danny-andersen/digi-thermostat/README.md

# digi-thermostat
Arduino project for a digital thermostat that allows remote control of a central heating boiler. Eat your heart out Nest.
