danny-andersen/digi-thermostat/Logic-Flow.pptx

Read
RTC

Read
PIR

Read
Button Inputs

Now >=
TempTime

Yes

Read
Thermometer
Set TempTime=now + temp delay

Read
Set Temp for
Time now

Tripped?

Yes

Temp+/-?

Yes

Inc/Dec
Set Temp

Override?

Yes

Set New_Boiler = on
Set BTimeOff = now + 30min

Set Temp
>
Current?

Yes

Set New_Boiler
= on

Now > LightTimer?

Set Backlight on
Set LightTimer=
now + 30s

No

Set New_Boiler
= off

Store new Set Temp
For time now

Set Backlight
off

[Turn Boiler off]
Boiler_on = 0
[Open Relay]

new_boiler == off &&
Now >= BTimeOff

True

[Turn Boiler on]
Boiler_on = 1
[Close relay]

False

Display:
Current Date + Time
Current Temp + RH
Set Temp
Boiler Status
(BTimeOff - now)

If mins != last_tx_mins
Send status
