danny-andersen/digi-thermostat/mainboard-stripboard-graphic.gif

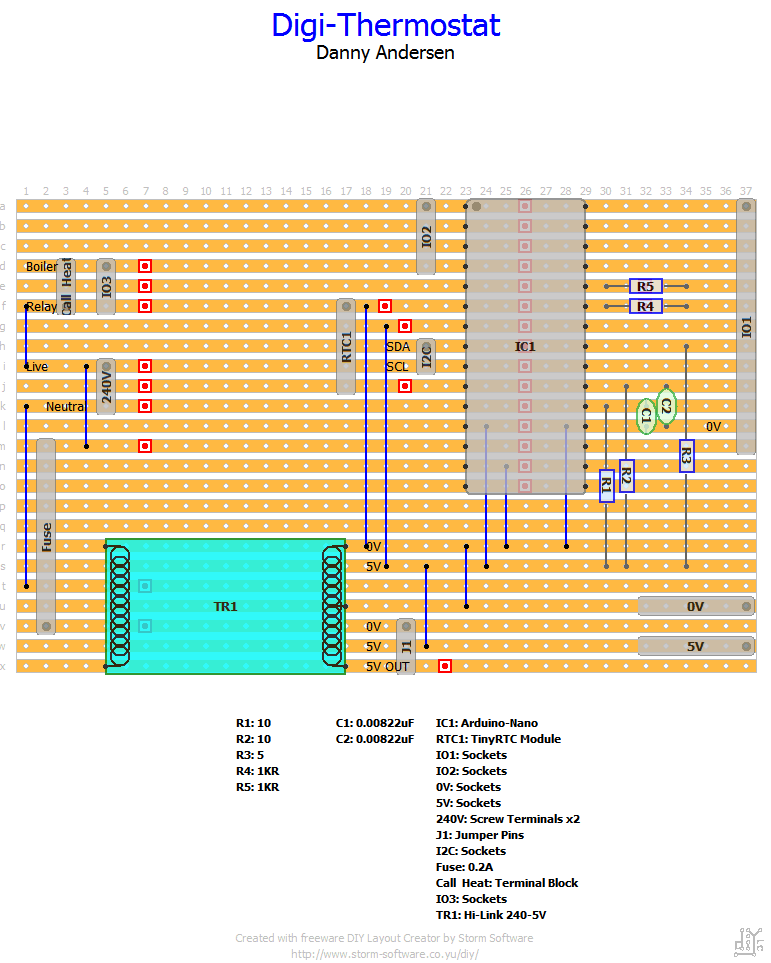
mainboard-stripboard-graphic.gif
