danny-andersen/digi-thermostat/Mainboard_schematic.pdf

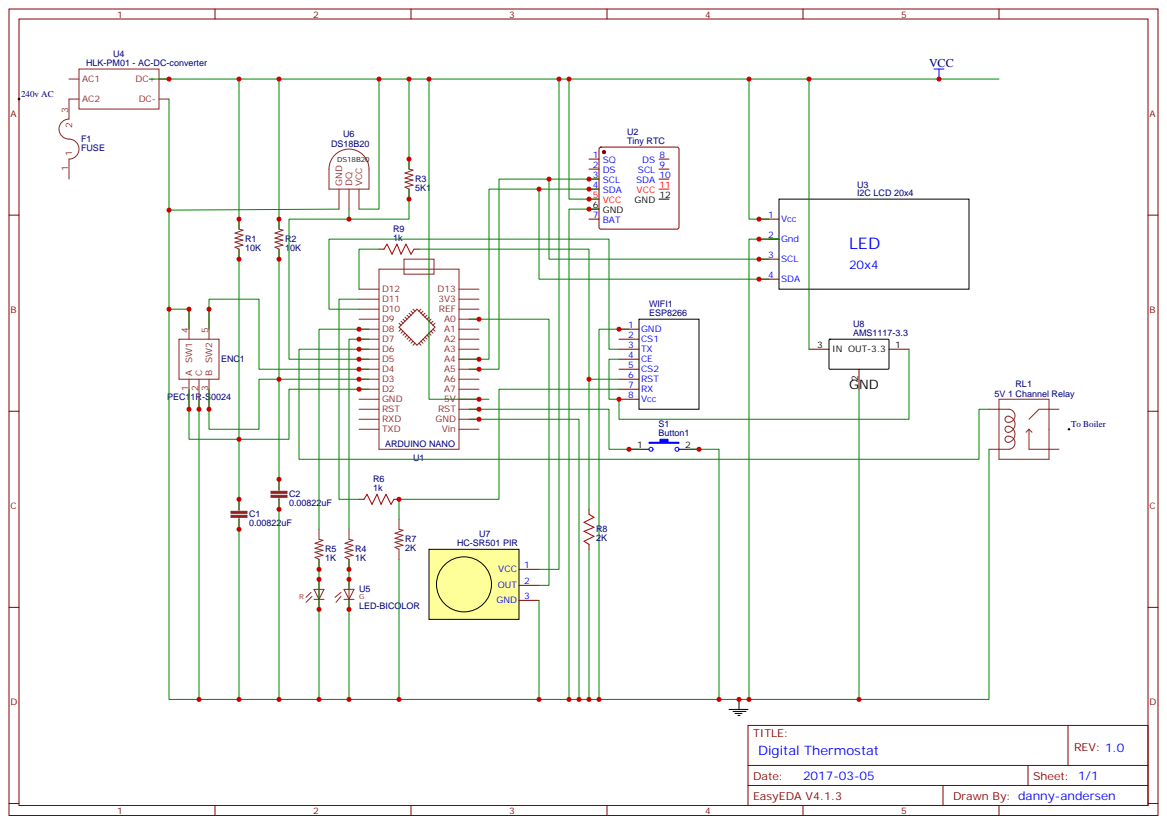
[picture p2: page 1]
