danny-andersen/digi-thermostat/mainboard_layout.pdf

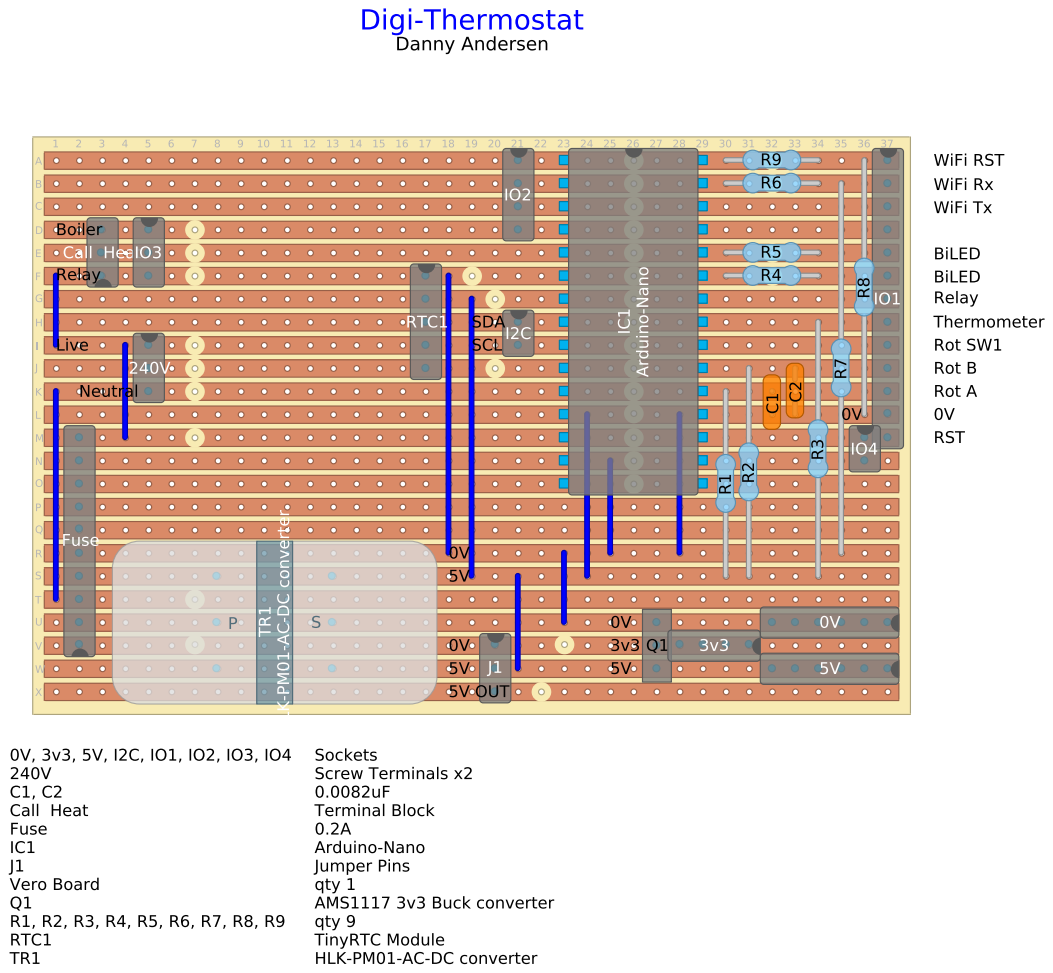
[picture p3: page 1]
