danny-andersen/digi-thermostat/(list of files, drawings)

Other design files:
Mainboard-Easyeda-source.json
