danny-andersen/digi-thermostat/monitor_home/capture-camera.py

from time import sleep
from fractions import Fraction
from picamera import PiCamera
from datetime import datetime
import subprocess
import os

WEB_CAM = False
DATE_FORMAT: str = "%Y%m%dT%H%M%S"
STATUS_FILE = "/home/danny/digi-thermostat/masterstation/status.txt"
MAX_LAST_UPDATE = 5 * 60
TAKE_PHOTO_FILE: str = "/home/danny/digi-thermostat/monitor_home/take-photo.txt"
DEVICES_FILE = "/home/danny/digi-thermostat/monitor_home/lan_devices.txt"


class Camera:
    _webcam_enabled: bool
    _camera: PiCamera
    photoFilenamePi: str = "-piphoto.jpeg"
    photoFilenameWeb: str = "-webphoto.jpeg"
    videoFilename: str = "-pioutput"

    ffmegStr = "ffmpeg -f v4l2 -video_size 1280x720 -i /dev/video1 -r 3.0 -frames 1 -y"
    mp4ConvStr = "MP4Box -add"
    devnull = " >/dev/null"

    def __init__(self, web_cam_on: bool, camera: PiCamera = None):
        self._webcam_enabled = web_cam_on
        self._camera = camera

    def _getCamera(self):
        if not self._camera:
            self._camera = PiCamera()
            self._camera.framerate = Fraction(25, 1)
            self._camera.iso = 800
        return self._camera

    def _closeCamera(self):
        if self._camera:
            self._camera.close()
            self._camera = None

    def takePhoto(self, dateStr: str):
        # Take photo with picam
        camera = self._getCamera()
        camera.resolution = (1024, 768)
        camera.capture(f"{dateStr}{self.photoFilenamePi}")
        self._closeCamera()
        if self._webcam_enabled:
            # Take webcam photo
            ffmegCmd: list = self.ffmegStr.split()
            ffmegCmd.append(f"{dateStr}{self.photoFilenameWeb}")
            ffmegCmd.append(self.devnull)
            subprocess.run(args=ffmegCmd)

    def takeVideo(self, dateStr: str):
        outfile: str = f"{dateStr}{self.videoFilename}"
        camera = self._getCamera()
        camera.start_recording(
            output=f"{outfile}.h264", format="h264", resize=(640, 480)
        )
        camera.wait_recording(30)
        camera.stop_recording()
        self.wrapH264(outfile)

    def wrapH264(self, videoName: str):
        mp4cmd: list = self.mp4ConvStr.split()
        mp4cmd.append(f"{videoName}.h264")
        mp4cmd.append(f"{videoName}.mp4")
        #    mp4cmd.append(devnull)
        # TODO run the conversion command in the background and delete following conversion
        subprocess.run(args=mp4cmd)
        os.remove(f"{videoName}.h264")


def readPirStatus():
    pir = False
    # First check that status file is recent - only read it if in past x mins
    statfile: os.stat_result = None
    try:
        statfile = os.stat(STATUS_FILE)
    except:
        statfile = None
    nowTime = datetime.now().timestamp()
    if statfile and (nowTime - statfile.st_mtime < MAX_LAST_UPDATE):
        with open(STATUS_FILE, "r", encoding="utf-8") as statusf:
            line: str = " "
            while line != "":
                line: str = statusf.readline()
                if line.startswith("PIR:"):
                    val = int(line[line.index(":") + 1])
                    if val:
                        pir = True
    return pir


def checkForPhotoCmd():
    # Check for photo command
    takePhoto: bool = False
    try:
        statfile = os.stat(TAKE_PHOTO_FILE)
        takePhoto = True
        os.remove(TAKE_PHOTO_FILE)
    except:
        takePhoto = False
    return takePhoto


# Check if any recognised mobile devices are on the network
def noOneHome():
    noOneHome = True
    try:
        statfile: os.stat_result = os.stat(DEVICES_FILE)
        # print(f"device file size: {statfile.st_size}")
        if statfile.st_size > 0:
            noOneHome = False
    except:
        noOneHome = True

    return noOneHome


# Start

camera: Camera = Camera(WEB_CAM)
while True:
    # if no one home - start monitoring
    if noOneHome():
        # Check pir is on
        while readPirStatus():
            # record in 30 second segments whilst pir status is on
            # and no one is home
            dateStr: str = datetime.now().strftime(DATE_FORMAT)
            camera.takePhoto(dateStr)
            camera.takeVideo(dateStr)
    if checkForPhotoCmd():
        dateStr: str = datetime.now().strftime(DATE_FORMAT)
        camera.takePhoto(dateStr)
    sleep(0.5)
