danny-andersen/digi-thermostat/masterstation/parse_bbc.py

if __name__ == "__main__":
    from bs4 import BeautifulSoup
    from datetime import datetime,time
    import sys

    if len(sys.argv) != 2:
	 sys.stderr.write("Please provide a file to parse\n")
	 sys.exit(1)
    html = BeautifulSoup(open(sys.argv[1]).read(), "lxml")
    #Find start of hourly forecast
    hourly = html.find("table", class_="moving-window");
    hours = []
    for tr in hourly.find_all(class_="time"):
        for th in tr.find_all("th"):
	    for hr in th.find_all("span",class_="hour"):
		hours.append(hr.string)
    print hours
    weather = []
    for tr in hourly.find_all(class_="weather-type"):
        for td in tr.find_all("td"):
	    for hr in td.find_all("img"):
	    	weather.append(hr["title"])
    print weather
    temp = []
    for tr in hourly.find_all(class_="temperature"):
	i = 0
        for td in tr.find_all("td"):
	    for hr in td.find_all("span",attrs={"data-unit": "c"}):
		i = True
	    	for st in hr.strings:
		    if (i):
		    	temp.append(st);
		    i = not i
    #Use observation module
    #tempTag = html.find("p", class_="temperature");
    #if (tempTag != None):
    #    for hr in tempTag.find_all("span",attrs={"data-unit": "c"}):
    #	   for st in hr.strings:
    #	       temp.append(st);
    print temp
    windSpeed = []
    windDirection = []
    for tr in hourly.find_all(class_="windspeed"):
        for td in tr.find_all("td"):
	   for hr in td.find_all("span",class_="windspeed-value-unit-mph"):
	    	for st in hr.stripped_strings:
    	   	    windSpeed.append(st);
	   for hr in td.find_all("span",class_="description"):
	    	for st in hr.stripped_strings:
    	   	    windDirection.append(st);
    windDir = windDirection[0].split()
    windDirAbbr = ""
    for wdw in windDir:
	windDirAbbr += wdw[0];
    wind = windSpeed[0]+windSpeed[1]+" " + windDirAbbr

    sunrise = html.find(class_="sunrise")
    sunriseStr = sunrise.string;
    sunriseHr = int(sunriseStr.split()[1].split(':')[0])
    sunset = html.find(class_="sunset")
    sunsetStr = sunset.string;
    sunsetHr = int(sunsetStr.split()[1].split(':')[0])

    #Find when the weather changes and say when
    startWeather = weather[0]
    end = 0
    endWeather = ""
    for s in weather:
	if s != startWeather:
	   endWeather = s
	   break
	end += 1
    if end >= len(hours): 
	end -= 1 
    #Look for rain
    rainTime = 0
    rain = ""
    for s in weather:
	if s == "Thunderstorm" or s.lower().find("rain") != -1:
	    rain = s
	    break
        rainTime += 1
    if rainTime >= len(hours): 
	rainTime = -1 

    #Put it all together
    forecast = startWeather + " until " + hours[end] + "00"
    if rainTime != -1 and rainTime != end and rain != startWeather:
	forecast += ". " + rain + " at " + hours[rainTime] + "00"
    elif endWeather != "":
	forecast += " and then " + endWeather
    now = datetime.now().time() 
    if now.hour <= sunriseHr + 1:
	forecast = sunriseStr + ", " + forecast
    elif now.hour > 14 and now.hour <= sunsetHr + 1:
	forecast = sunsetStr + ", " + forecast
    #print forecast
    expiry = abs(now.hour - int(hours[end])) * 3600 * 1000;

    #Save output into files for sending to thermostat
    #Save first hour temp as ext temp
    with open("setExtTemp.txt", "w") as f:
	f.truncate()
	f.write(temp[0] + "\n")
    	f.write(wind + "\n")
    #Add expiry to motd
    with open("motd.txt", 'w') as f:
	f.truncate()
	f.write(forecast + "\n")
	f.write("%d" % expiry + "\n")
    
