danny-andersen/digi-thermostat/(commit log)

2017-01-22 Corrected rtc date conversion
    [digi-thermostat.ino, read_thermometer_display_oled.ino, thermometer_and_RTC.ino]
2017-01-23 Changed display to LCD as OLED unreliable I2C interface
2017-01-25 Added switches and schedule processing
2017-01-27 Debounced buttons
2017-01-29 Changed to a 20x4 LCD display. Added run timers
2017-02-03 Configured radio and changed to use rotary encoder to set temp
2017-02-04 Better debounce of ALPS rotary encoder to set temp
2017-02-20 Change rotary encoder for PEC11R unit which has proper phase shifted A and B signals
2017-02-26 Fixed set of clock
    [digi-thermostat.ino]
2017-03-01 Corrected LCD backlight and added processing of BBC weather site data
    [parse_bbc.py]
2017-03-03 Fixed sending and saving schedules
    [masterstation.cpp]
2017-03-03 Fixed saving of schedules by adding delay after write
    [digi-thermostat.ino]
2017-03-03 Fixed runtime calc and display of temp <10
    [digi-thermostat.ino]
2017-03-04 Bit of rewiring and added relay
2017-03-05 Fixed wind speed display
    [digi-thermostat.h, digi-thermostat.ino]
2017-03-06 Added first drafft of schematic
2017-03-06 Added final version of schematic
2017-03-13 Committed correct version of masterstation
    [digi-thermostat.h, masterstation.cpp]
2017-03-17 Updated schematic
2017-03-19 Added veroboard layout
    [Mainboard-Easyeda-source.json]
2017-03-25 Set power to the max
2017-04-09 Reset radio if msg not received for a while as radio appears to hang periodically and needs to be reset
    [digi-thermostat.h, digi-thermostat.ino]
2017-05-12 Fixed sendTemp bug when temp not read correctly
    [masterstation.cpp]
2018-08-27 Added safe devices
2019-04-22 Changed Temp in devices file to show tenths of degree and added boiler status change
2021-05-23 Fixed re-installation errors and changes
    [masterstation.cpp]
2021-05-24 Fixed null temperature reading and added missing files required on first run
2022-09-27 Major changes to use wifi module rather than RF24 radio for more reliable comms
    [Mainboard-Easyeda-source.json]
2022-09-30 Fixed sending boiler runtime and pir status
    [digi-thermostat.h, digi-thermostat.ino]
2022-10-10 Various display fixes and RTC fixes
    [digi-thermostat.h, digi-thermostat.ino, masterstation.py]
2022-10-11 Fixed display errors and calc of manual holiday time
    [digi-thermostat.h, digi-thermostat.ino]
2022-10-11 Fixed holiday sending and boiler off status
    [masterstation.py]
2022-10-12 Changed holiday adj to 15mins. Attempt fix at local therm reading
    [digi-thermostat.h, digi-thermostat.ino]
2022-10-16 Fixed Run time being too long
    [digi-thermostat.ino]
2022-10-17 Corrected schedule day due to RTC day change
    [digi-thermostat.ino, masterstation.py]
2022-11-08 Reset if wifi down for more than 15mins and dont allow manual override of holiday temp
    [digi-thermostat.h, digi-thermostat.ino, wifi.h]
2022-11-30 Fixed motdexpiry being less than zero
    [masterstation.py]
2022-12-11 Added remote reset functionality
    [digi-thermostat.h, digi-thermostat.ino, masterstation.py]
2022-12-13 Adjust local temp read, corrected temp display Fixed sending reset command
    [digi-thermostat.h, digi-thermostat.ino, masterstation.py]
2022-12-14 Fixed overriding temp during man holiday. Also rounded holiday time to nearest 15 mins Also fixed boiler run time - send mins not tms
    [digi-thermostat.ino]
2022-12-16 Fixed backlight not switching off by changing LCD library
    [digi-thermostat.ino]
2023-01-02 First commit of new camera capture based on PIR status
2023-01-02 Added constructor to Camera class
2023-01-02 Added arduino vscode config
2023-01-02 Run camera capture and monitor script on threads off masterstation.service
2023-01-03 Release file lock once threads created
2023-01-03 Run uwsgi web server with uid and gid set Allows threads to work correctly
2023-01-04 Changed tp multiprocess rather than threads
2023-01-07 Stop taking pictures every hour Only do if no devices in camera capture
2023-01-07 Changed network failure handling. Fixed next schedule at weekend
    [digi-thermostat.h, digi-thermostat.ino]
2023-01-08 Corrected updated status file on change
    [masterstation.py]
2023-01-15 Do a full reset if not heard from masterstation for 3x wifi timeout And set temp to invalid if local therm is broken and no remote temp
    [digi-thermostat.h, digi-thermostat.ino]
2023-01-18 Replaced PIR sensor and so re-enabled out of hours video taking
2023-01-18 Added humidity sensor Moved reading sensor to monitor thread to speed up response times
2023-01-18 Moved reading sensor to monitor thread
2023-01-18 Ignore sensor failure value
    [masterstation.py]
2023-01-22 Reset device after x3 wifi reboots every 5mins Send wifi reset in reset flag
    [digi-thermostat.h, digi-thermostat.ino, masterstation.py]
2023-01-22 Added libraries local to sketch as per Arduino ide change
2023-01-27 Calculate average temp + humidty for history Edit lan devices rather than creating from new
2023-02-03 Fixed truncation of device change file
2023-03-04 Added timeout on waiting for camera completing
2023-03-04 Added missing date to device file
2023-09-13 Added missing files from backup post recovery
    [thermometer_and_RTC.ino]
2023-09-13 Changed overnight camera monitor times
2023-09-22 First commit of new security camera module
    [cam0-motion.cfg, masterstation-motion.cfg]
2023-09-23 First running version of camera monitoring
    [cam0-motion.cfg]
2023-10-06 Fixed set temp float issue Processed external temp and camera
    [masterstation.py]
2023-11-02 Tuned motion settings
    [cam0-motion.cfg]
2023-11-02 Set ext temp if external camera status
2023-11-02 change motion cfg file name
    [masterstation-motion.cfg]
2023-11-03 Use DS18B20 device if DHT22 returns bad results
2023-11-19 Fixed holiday save to EEPROM and restore on reboot
    [digi-thermostat.ino]
