danny-andersen/digi-thermostat/(notices)

Notices in the files:
helloworld_rx/helloworld_rx.ino:
modify it under the terms of the GNU General Public License
